upenn-embedded/final-project-s26-t11/Gimbal_Code/joystick.h

#ifndef JOYSTICK_H
#define JOYSTICK_H

#include <avr/io.h>
#include <stdint.h>

void     joystick_init(void);
uint16_t joystick_read_raw(void);
uint16_t joystick_read_horizontal_raw(void);
int8_t   joystick_read_vertical_step(void);
int8_t   joystick_read_horizontal_step(void);

#endif
