upenn-embedded/final-project-s26-t11/(commit log)

2026-03-15 added link to google sheet BOM
2026-03-16 added spring functionality details
2026-03-16 ESP32 changes
2026-03-16 added to include esp32
2026-04-10 failed code for BNO085
    [main.c, uart.c]
2026-04-10 code for other IMU
2026-04-11 added pic of cad
2026-04-23 edited PID constants
2026-04-23 improved pitch and roll estimation for IMU
2026-04-24 button and interrupt working
2026-04-24 yay! this works! old PID but the button and whole functionality bar joystick works
2026-04-24 edited IMU code for more stability
    [lsm6ds0.c]
2026-04-28 fixed error in joystick code
    [joystick.c]
2026-04-28 adjusted PID constants
2026-04-29 did some more AI to remove button
