upenn-embedded/final-project-s26-t11/image/README/mechDesign.jpg

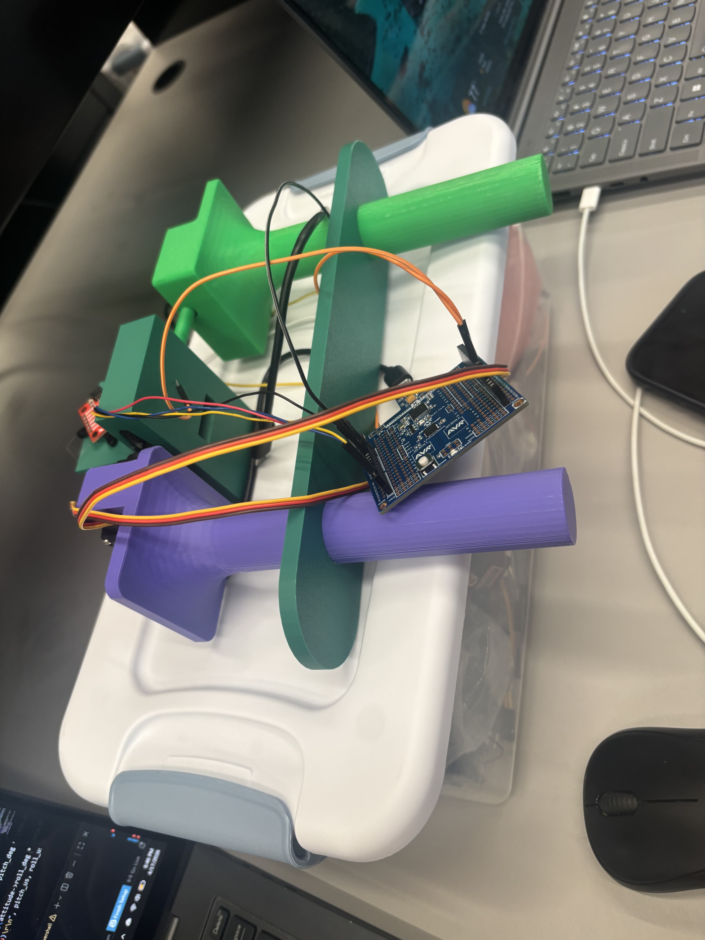
[picture p9: mechDesign.jpg]
image/README/mechDesign.jpg
