upenn-embedded/final-project-s26-t11/image/README/1777345931214.jpg

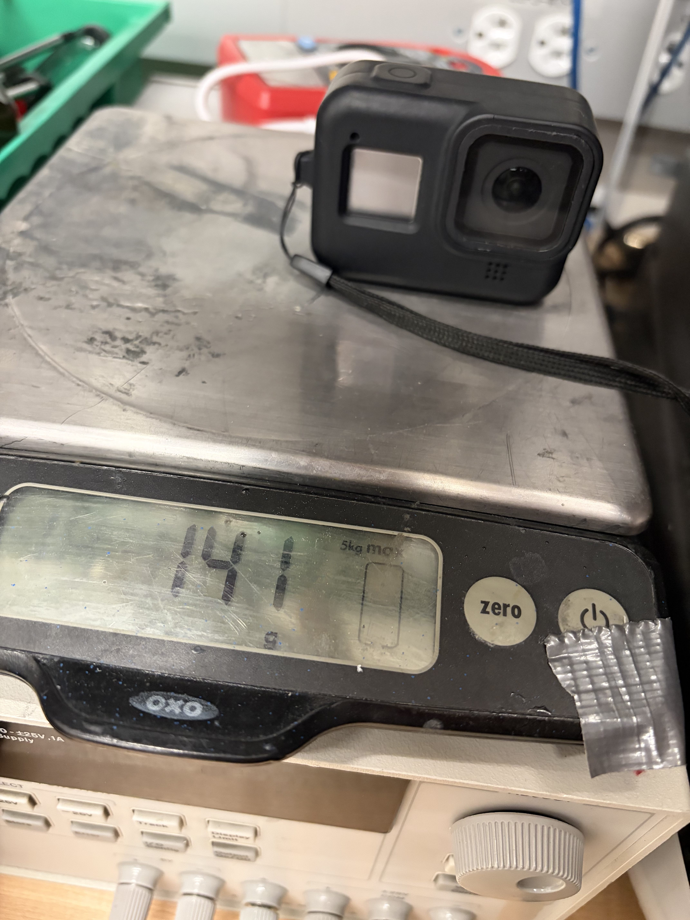
[picture p21: image/README/1777345931214.jpg]
image/README/1777345931214.jpg
